mike-rankin/ESP32_Pico/Images/Front.JPG

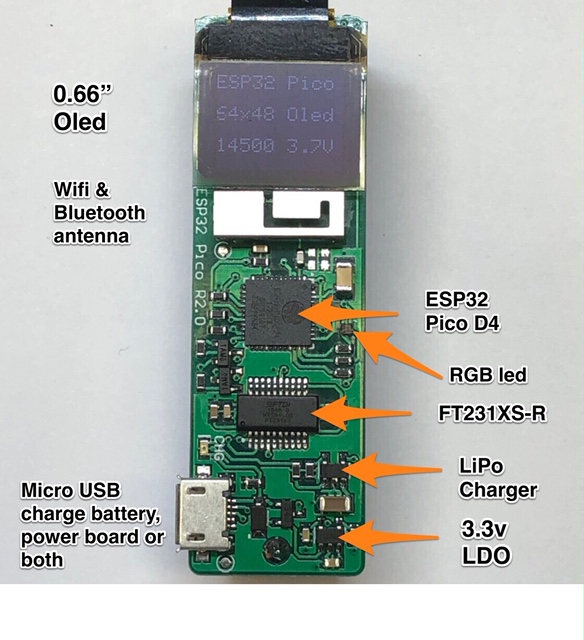
Images/Front.JPG
