mike-rankin/ESP32_Pico/README.md

# ESP32 Pico
front

ESP32 Pico D4 project with 0.66" Oled Display
This design was an experiment using new to me parts like the ESP32 Pico D4, 14500 LiPo battery, 1mmx1mm RGB led and a metal wifi\bluetooth antenna. It can be powered off of a battery or USB cable. If a battery is inserted and USB cable is plugged in it will charge the battery and power the board. This project was not created for any specific purpose but just an excuse to test out a few new parts. If you come up with an idea for this hardware then just let me know at @mikerankin

https://youtu.be/WG5k9fxXMjg

The bare PCB was provided by [PCBWay](https://www.pcbway.com/project/shareproject/ESP32_Pico_D4_Dev_Board.html) and parts by [LCSC](http://lcsc.com).
