mike-rankin/ESP32_Pico/PCB/Parts_List.xlsx

Sheet: Part List Report
 | Component list |  |  | ESP32 Pico
 | Source Data From: |  |  | Revision 2
 | Project:
 | Report Date: |  | 2018-12-23 | 12:19:26 PM
 | Print Date: |  | 2018-12-23 | 12:21:10
# | Designator | Quantity | Vendor | PartNumber | Description | Manufacturer
1 | ANT1 | 1 | Digi-Key | PRO-OB-440 | RF ANT 2.4GHZ STAMPED MET SLD | Proant AB
2 | B1 | 1 | LCSC | 1028 | 14500 Battery Holder | Keystone
3 | C1, C2, C5, C12 | 4 | LCSC | 0603B105K160NT | CAP CER 1uF 16V X7R 0603 | GFAT
4 | C3 | 1 | LCSC | 0603N4R7C500CT | CAP CER 47pF 50V 0603 | Huaxin
5 | C4 | 1 | LCSC | 0603N2R7C500 | CAP CER 2.7pF 50V 0603 | Huaxin
6 | C6, C7, C8 | 3 | LCSC | 0603B104K160CT | CAP CER 0.1uF 16V 10% X7R 0603 | Huaxin
7 | C9, C11, C14 | 3 | LCSC | 0603B225K160NT | CAP CER 2.2uF 16V X5R 0603 | GFAT
8 | C10 | 1 | LCSC | 0603B475K160NT | CAP CER 4.7uF 16V X7R 0603 | GFAT
9 | C13 | 1 | LCSC | 06035C103KAT2A | CAP CER 10nF 50V 0603 | AVX
10 | C15 | 1 | LCSC | JMK316BJ107ML-T | CAP CER 100uF 6.3V 1206 | Taiyo Yuden
11 | C16 | 1 | LCSC | TMK316B7106KL-TD | CAP CER 10uF 16V 10% X7R 1206 | Taiyo Yuden
12 | D1 | 1 | LCSC | MBR0520 | DIODE SCHOTTKY 20V 500MA SOD123 | CJ
13 | D2 | 1 | LCSC | FC-DA1608HRK-620D | LED RED CLEAR 0603 SMD | FNO
14 | D3 | 1 | LCSC | FC-B1010RGBT-HG | LED,RGB,SMD,RoHS | Foshan
15 | H1 | 1 | LCSC | C21377 | CONN RCPT MICRO USB TYPE AB | REG CON
16 | L1 | 1 | LCSC | BKW0603UC1N8KGT | Inductor 1.8nH 0603 | GFBE
17 | Q1 | 1 | LCSC | FDN340P | MOSFET P-CH 20V 2A SOT-23 | On Semi
18 | Q2, Q3 | 2 | LCSC | MMBT3904 | TRANS NPN GP 40V SOT23 | SK
19 | R1, R5, R16, R17, R18 | 5 | LCSC | RCT0310KFLF | RES SMD 10K OHM 1% 1/10W 0603 | HK Resistors
20 | R2, R3 | 2 | LCSC | RCT034K7FLF | RES SMD 4.7K OHM 1% 1/10W 0603 | HK Resistors
21 | R4 | 1 | LCSC | RCT03390KFLF | RES SMD 390K OHM 1% 1/10W 0603 | HK Resistors
22 | R6, R8 | 2 | LCSC | RCT0310KFLF | RES SMD 10K OHM 1% 1/10W 0603 | HK Resistors
23 | R7, R10 | 2 | LCSC | RCT0327RFLF | RES SMD 27 OHM 1% 1/10W 0603 | HK Resistors
24 | R9 | 1 | LCSC | RCT03100KFLF | RES SMD 100K OHM 1% 1/10W 0603 | HK Resistors
25 | R15 | 1 | LCSC | RCT032KFLF | RES SMD 2K OHM 1% 1/10W 0603 | HK Resistors
26 | R19, R20, R21 | 3 | LCSC | RCT031KFLF | RES SMD 1K OHM 1% 1/10W 0603 | HK Resistors
27 | U1 | 1 | LCSC | ESP32-PICO-D4 | RF Transceiver ICs QFN-48_7x7x05P RoHS | Espressif
28 | U2 | 1 | LCSC | FT231XS-R | USB Bridge, USB to UART Interface 20-SSOP | FTDI
29 | U3 | 1 | LCSC | SE5218ALG-LF | IC REG LDO 3.3V 0.5A SOT23-5 | Seaward
30 | U4 | 1 | LCSC | SL4054ST25P | Charger IC Lithium-Ion/Polymer SOT23-5 | Techfuse
31 | X1 | 1 | LCSC | UG-6448KLBEG03 | 0.66 inch OLED_GLASS | Univision
Approved |  |  |  | Notes

Sheet: Project Information
Project Full Path | C:\Users\Lenovo\Dropbox\Arduino_PCB\ESP32_Mini\PCB_Project.PrjPCB
Project Filename | PCB_Project.PrjPCB
Variant Name | None
Data-Source Filename | PCB_Project.PrjPCB
Data-Source Full Path | C:\Users\Lenovo\Dropbox\Arduino_PCB\ESP32_Mini\PCB_Project.PrjPCB
Title | Bill of Materials For Project [PCB_Project.PrjPCB] (No PCB Document Selected)
Total Quantity | 48
Report Time | 12:19:26 PM
Report Date | 2018-12-23
Report Date & Tine | 2018-12-23 12:19:26 PM
Output Name | Bill of Materials
Output Type | BOM_PartType
Output Generator Name | BOM
Output Generator Description | Bill of Materials
