mike-rankin/ESP32_Pico/PCB/Schematic_Rev2.pdf

# Fix on next revision

# - RGB LED footpring wrong

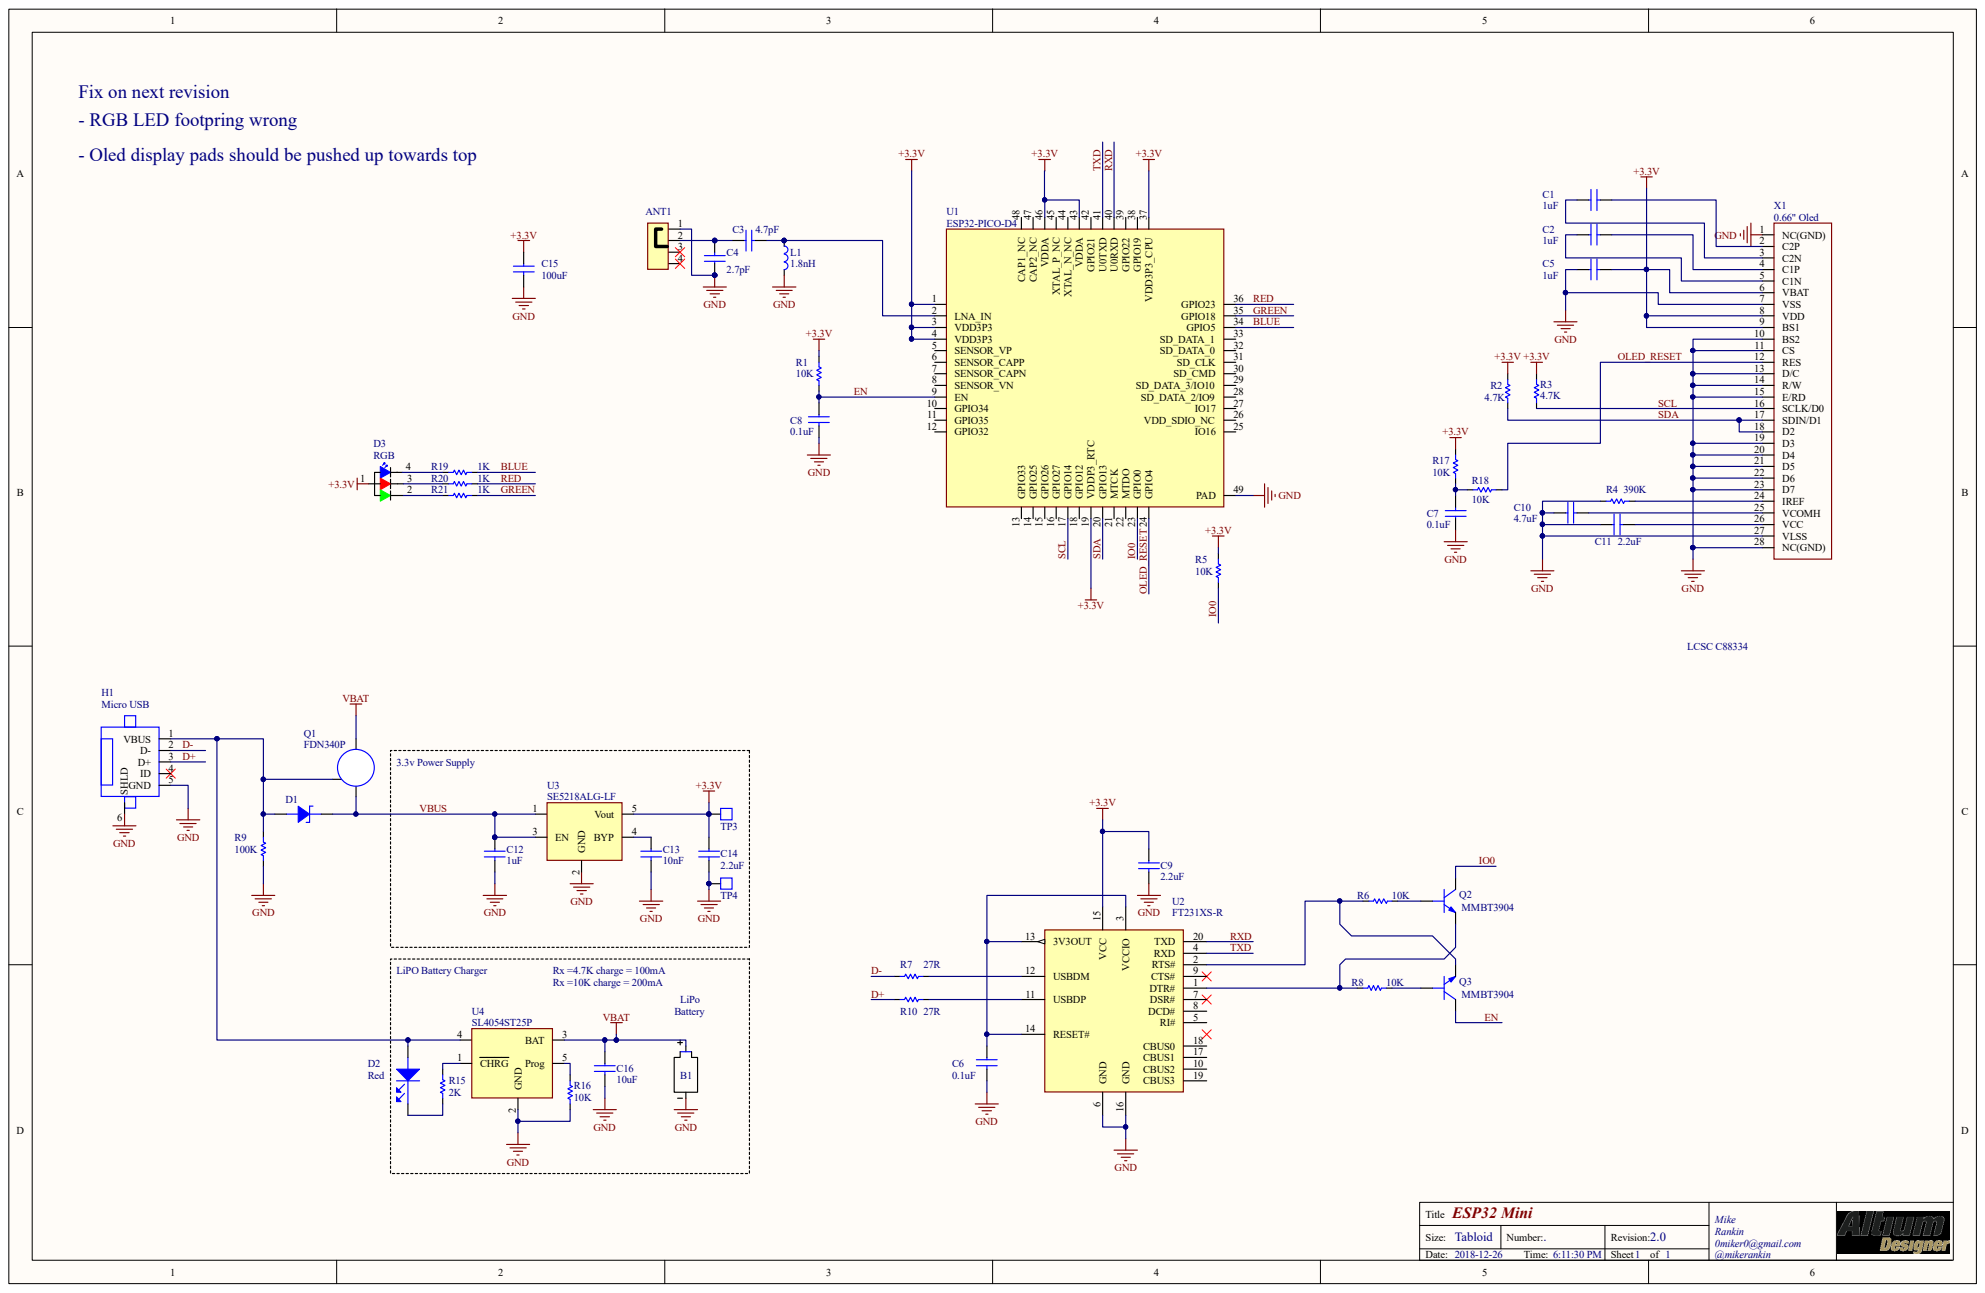
[picture p2: page 1]

- Oled display pads should be pushed up towards top
