mike-rankin/ESP32_Pico/PCB/Parts_Placement.pdf

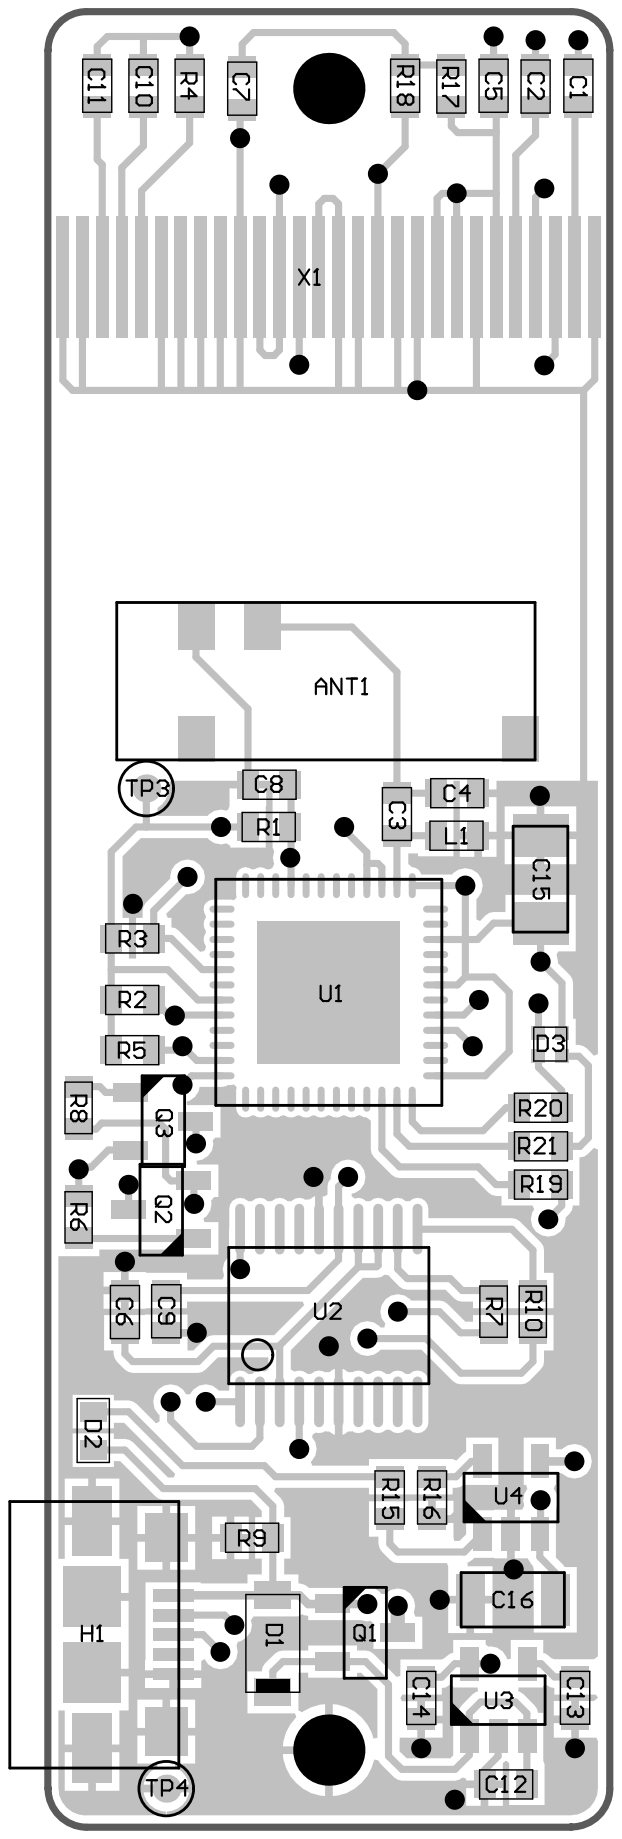
[picture p3: page 1]
